tehKaiN/plipUltimate/(threads)

Thread 1 (2017-03-11):

Rev3 PCB

tehKaiN, 2017-03-11:
- [ ] proper power selector circuit
- [ ] better eth connector footprint - current is hard to source. Perhaps it'd be better to use non-LED variant & move leds to PCB
- [ ] CON5 should be place a bit lower
- [ ] Upper mounting hole of SD connector is too small
- [ ] Add power LED

LM2596 issues:
- [ ] L2 is wrongly wired, all LM2596 output should go through it
- [ ] C18 is wrongly wired, should be before power mux
