tehKaiN/plipUltimate/pcb/plipUltimate.kicad_pcb

## KiCad design pcb/plipUltimate.kicad_pcb (2016-05-31)

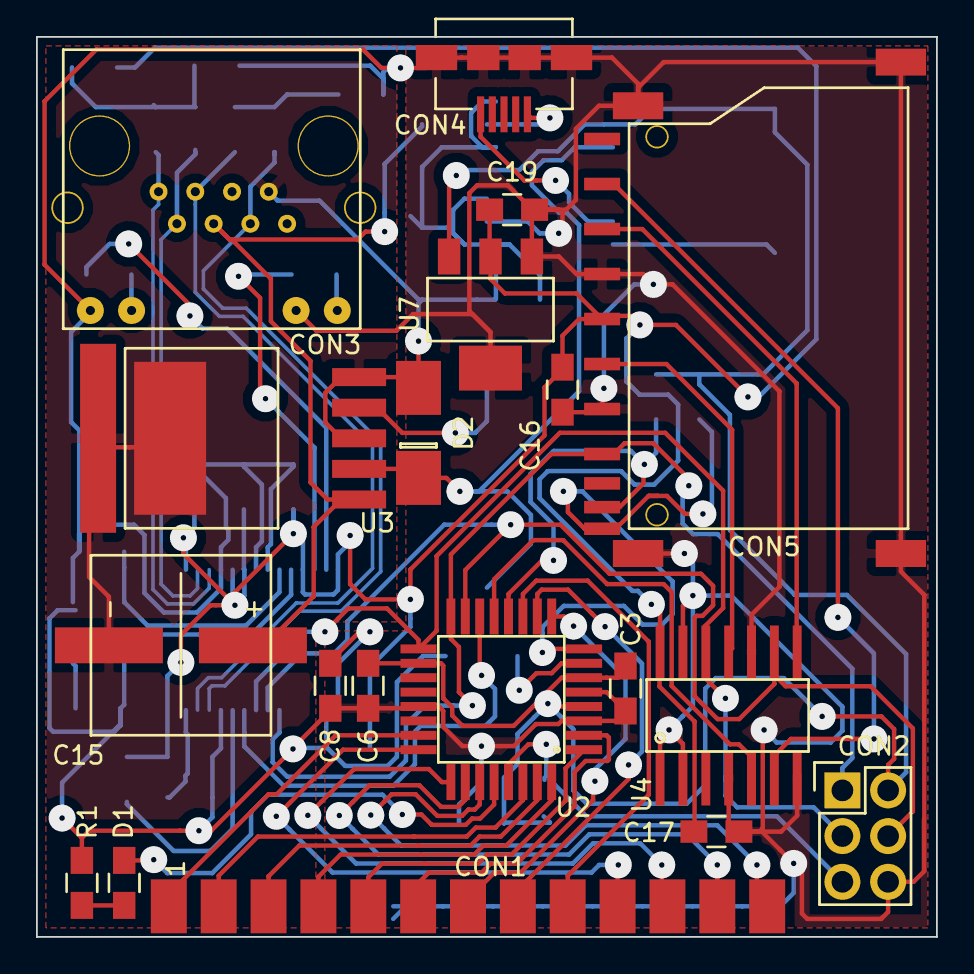
[picture p1: board plipUltimate.kicad_pcb from above]

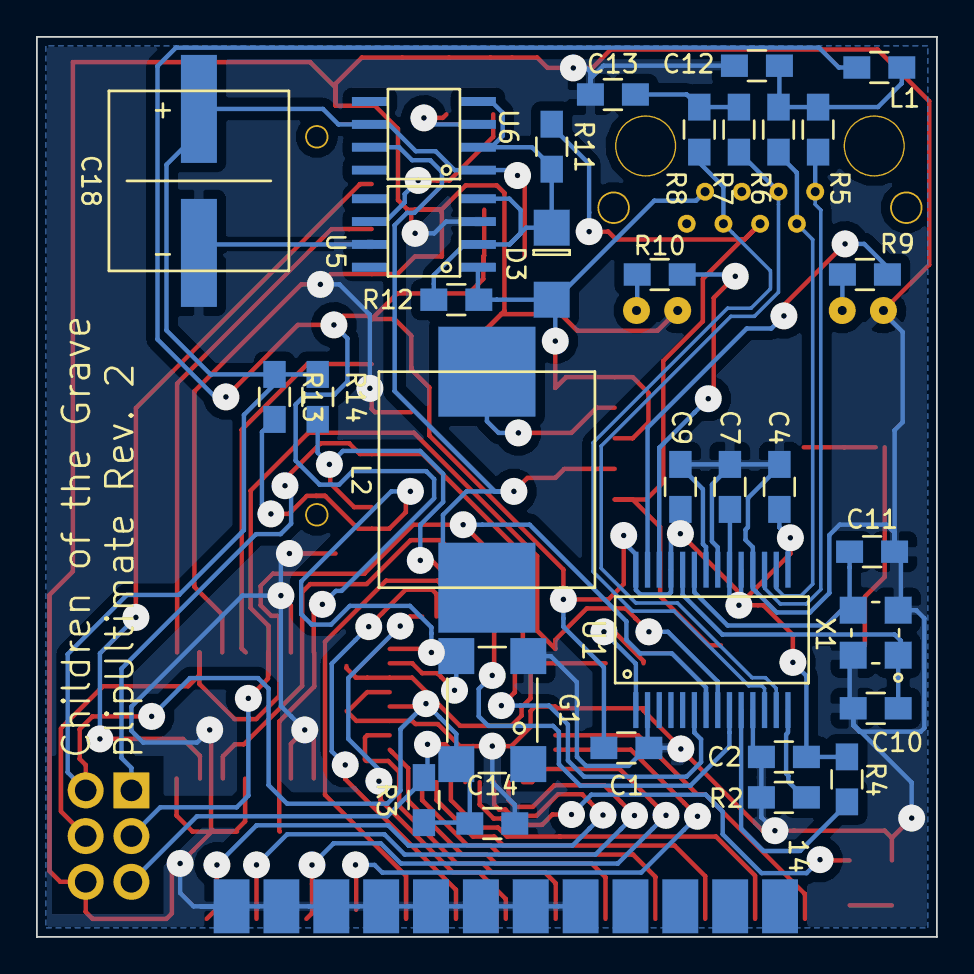
[picture p2: board plipUltimate.kicad_pcb from below]

Board: 2 copper layers, 50.0 x 50.0 mm, 51 parts (32 on the bottom side), 52 nets.

Parts:
C1, C2, C3, C4, C6, C7, C9, C14, C16: 100nF; 0805
C8: 10uF; 0805
C10, C11: 18pF; 0805
C12, C13, C17: 10nF; 0805
C15: 100uF 50V loESR; electrolyte_SMD
C18: 220uF 35V loESR; electrolyte_SMD
C19: 10uF 6,3V; 0805
CON1: IEEEE-1284A; d-sub25_edge
CON2: AVR-ISP-6; IDC_2x3
CON3: RJ45_C; RJ45-LEDS
CON4: USB_microB; USB-MicroB
CON5: SD_SPI; SD-SHORT
D1: YEL_LED; 0805
D2: SS34; SMA
D3: BZV55C10; SOD-80
G1: CFPS-72-20M; SMD_7050
L1: FB 100mA; 0805
L2: DE1207-100; DE-1207
R1: 820R; 0805
R2: 2k7 1%; 0805
R3, R4, R12: 10k; 0805
R5, R6, R7, R8: 49R9 1%; 0805
R9, R10: 270R; 0805
R11: 22k; 0805
R13, R14: 4k7; 0805
U1: ENC28J60; SSOP-28
U2: ATMEGA328P; TQFP-32
U3: LM2596_5.0; TO-263
U4: 74LVC125; SO-14
U5, U6: IRF7309; SO-8
U7: AMS1117_3V3; SOT-223
X1: 25MHz; XT-324

Connections:
3.3V_AVR_MOSI: CON5.2, U4.8
3.3V_AVR_SCK: CON5.5, U4.11
3.3V_SD_CS: CON5.1, U4.6
+3V3: C1.2, C2.2, C4.2, C7.2, C9.2, C16.1, C17.1, C19.1, CON5.4, L1.1, R4.1, U1.15, U1.19, U1.20, U1.25, U1.28, U4.14, U7.2
+5V: C3.1, C6.1, C14.1, C18.1, CON2.2, G1.4, R3.1, R13.1, R14.1, U2.4, U2.6, U2.18, U6.1, U6.6, U7.3
/AVR_CLK: G1.3, U2.7
/BUSY: CON1.11, U2.25
/D0: CON1.2, U2.30
/D1: CON1.3, U2.31
/D2: CON1.4, U2.32
/D3: CON1.5, U2.1
/D4: CON1.6, U2.2
/D5: CON1.7, U2.9
/D6: CON1.8, U2.10
/D7: CON1.9, U2.11
/LEDA: R9.2, U1.27
/LEDB: R10.2, U1.26
/OSC1: C11.2, U1.23, X1.3
/OSC2: C10.2, U1.24, X1.1
/POUT: CON1.12, U2.26
/RX+: CON3.3, R7.1, U1.13
/RX-: CON3.6, R8.1, U1.12
/SEL: CON1.13, U2.27
/TX+: CON3.1, R5.2, U1.17
/TX-: CON3.2, R6.2, U1.16
/~ACK: CON1.10, U2.24
/~STROBE: CON1.1, U2.23
AVR_MISO: CON2.1, CON5.7, U1.6, U2.16
AVR_MOSI: CON2.4, U1.7, U2.15, U4.9
AVR_RESET: CON2.5, R3.2, U2.29
AVR_SCK: CON2.3, U1.8, U2.17, U4.12
ETH_CS: U1.9, U2.14
GND: C1.1, C2.1, C3.2, C4.1, C6.2, C7.1, C8.1, C9.1, C10.1, C11.1, C12.1, C13.1, C14.2, C16.2, C17.2, C18.2, C19.2, CON1.18, CON1.19, CON1.20, CON1.21, CON1.22, CON1.23, CON1.24, CON1.25, CON2.6, CON3.9, CON3.11, CON4.6, CON5.3, CON5.6, CON5.12, CON5.13, G1.2, R1.2, R2.2, U1.2, U1.11, U1.18, U1.21, U1.22, U2.3, U2.5, U2.21, U4.1, U4.2, U4.4, U4.7, U4.10, U4.13, U5.3, U5.7, U7.1, X1.2
unnamed: C8.2, U1.1
unnamed: C12.2, L1.2, R5.1, R6.1
unnamed: C13.2, R7.2, R8.2
unnamed: CON3.10, R9.1
unnamed: CON3.12, R10.1
unnamed: CON4.1, U6.3
unnamed: CON4.5, U5.6
unnamed: D1.1, R1.1
unnamed: D1.2, U2.28
unnamed: D2.1, L2.2, U3.2, U6.7
unnamed: D3.1, R11.1, R12.2, U5.2, U5.4, U6.2, U6.4
unnamed: L2.1, U3.4
unnamed: R2.1, U1.14
unnamed: R4.2, U1.10
POE_0V: C15.2, CON3.7, D2.2, D3.2, R12.1, U3.3, U3.5, U5.1
POE_+24V: C15.1, CON3.4, R11.2, U3.1
SD_CS: U2.13, U4.5
SD_DETECT: CON5.10, R13.2, U2.8
SD_LOCK: CON5.11, R14.2, U2.12
