tehKaiN/plipUltimate/src/main/cmdkey_table.c

/*
 * This file is part of PlipUltimate.
 * License: GPLv2
 * Full license: https://github.com/tehKaiN/plipUltimate/blob/master/LICENSE
 * Authors list: https://github.com/tehKaiN/plipUltimate/blob/master/AUTHORS
 */

#include <main/cmdkey_table.h>

#include <main/stats.h>
#include <main/base/uartutil.h>

/*
COMMAND_KEY(cmd_dump_stats)
{
  stats_dump_all();
}

CMDKEY_HELP(cmd_enter_bridge_mode, "enter bridge mode");
CMDKEY_HELP(cmd_enter_bridge_test_mode, "enter bridge test mode");
CMDKEY_HELP(cmd_enter_pio_test_mode, "enter PIO test mode");
CMDKEY_HELP(cmd_enter_pb_test_mode, "enter PB test mode");
CMDKEY_HELP(cmd_dump_stats, "dump statistics");
CMDKEY_HELP(cmd_reset_stats, "reset statistics");
CMDKEY_HELP(cmd_toggle_verbose, "toggle verbose output");
CMDKEY_HELP(cmd_send_test_packet, "send a test packet (pbtest mode)");
CMDKEY_HELP(cmd_send_test_packet_silent, "send a test packet (silent) (pbtest mode)");
CMDKEY_HELP(cmd_toggle_auto_mode, "toggle auto send (pbtest mode)");

const cmdkey_table_t PROGMEM cmdkey_table[] = {
  CMDKEY_ENTRY('s', cmd_dump_stats),
  { 0,0 }
};
*/
