tehKaiN/plipUltimate/src/main/pio_util.c

/*
 * This file is part of PlipUltimate.
 * License: GPLv2
 * Full license: https://github.com/tehKaiN/plipUltimate/blob/master/LICENSE
 * Authors list: https://github.com/tehKaiN/plipUltimate/blob/master/AUTHORS
 */

#include <main/pio_util.h>

#include <main/base/timer.h>
#include <main/pio.h>
#include <main/base/uartutil.h>
#include <main/stats.h>
#include <main/pkt_buf.h>
#include <main/config.h>

#include <main/net/net.h>
#include <main/net/eth.h>
#include <main/net/arp.h>
#include <main/net/ip.h>
#include <main/net/udp.h>
#include <main/spi/enc28j60.h>

uint8_t pio_util_get_init_flags()
{
  uint8_t flags = PIO_INIT_BROAD_CAST;

  if(g_sConfig.flow_ctl) {
    flags |= PIO_INIT_FLOW_CONTROL;
  }
  if(g_sConfig.full_duplex) {
    flags |= PIO_INIT_FULL_DUPLEX;
  }

  return flags;
}

/**
 * Receives data from ENC28j60, calculates stats & does logging.
 * @param pDataSize Pointer to addr to be filled with read data size.
 */
uint8_t pio_util_recv_packet(uint16_t *pDataSize)
{
  // Fetch packet from ENC28j60, measure elapsed time
  timerReset();
  uint8_t ubRecvResult = enc28j60_recv(g_pDataBuffer, DATABUF_SIZE, pDataSize);
  uint16_t uwTimeDelta = timerGetState();
  uint16_t uwDataRate = timerCalculateKbps(*pDataSize, uwTimeDelta);

  if(ubRecvResult == PIO_OK) {
		// Update stats - write new data size & rate
    stats_update_ok(STATS_ID_PIO_RX, *pDataSize, uwDataRate);
  }
  else {
		// Update stats - increase error count
    stats_get(STATS_ID_PIO_RX)->err++;
  }

  return ubRecvResult;
}

uint8_t pio_util_send_packet(uint16_t size)
{
  timerReset();
  uint8_t result = enc28j60_send(g_pDataBuffer, size);
  // NOTE(KaiN#7): Is it really that short?
  uint16_t delta = timerGetState();

  uint16_t rate = timerCalculateKbps(size, delta);
  if(result == PIO_OK) {
    stats_update_ok(STATS_ID_PIO_TX, size, rate);
  }
  else {
    stats_get(STATS_ID_PIO_TX)->err++;
  }

  return result;
}
