tehKaiN/plipUltimate/(commit log)

2016-05-17 Added global pinout config, introduced SPI SD card support
2016-05-17 file reorganization, added spi support for card reader
2016-05-17 converted to stdint.h types, minor fixes
    [bridge.c, cmd.c, cmd.h, cmd_table.c]
2016-05-17 added PCB KiCad project
    [plipUltimate.kicad_pcb, plipUltimate.sch]
2016-05-18 Minor KiCad schematic fixes
    Tweaked resistor symbol, added SD decoupling, changed module layout on
    page
    [plipUltimate.sch]
2016-05-19 Added d-sub 25 edge connector footprint
2016-05-19 Added hand solder footprints, MOSFET gate powered by zener regulator
    [plipUltimate.sch]
2016-05-20 Decoupling for 7407, minor schematic tweaks
    most parts are associated with footprints, added more of them
    [plipUltimate.sch]
2016-05-21 All footprints done!
    [plipUltimate.sch]
2016-05-21 Laid out power circuit
    [plipUltimate.kicad_pcb, plipUltimate.sch]
2016-05-22 Changed eth crystal to 3-pin SMD, all parts are aligned on board now
    [plipUltimate.sch]
2016-05-22 further layout work - 25 connections to go
    [plipUltimate.kicad_pcb, plipUltimate.sch]
2016-05-24 everything routed!
    TODO: home-etching optimizations
    [plipUltimate.kicad_pcb]
2016-05-26 Revised schematic, reroute in progress
    [plipUltimate.kicad_pcb, plipUltimate.sch]
2016-05-30 Complete rev 2 sch and PCB
    [plipUltimate.kicad_pcb, plipUltimate.sch]
2016-05-30 minor pcb fixes
    TODO: 20MHz & SD footprints are broken
    [plipUltimate.kicad_pcb]
2016-05-31 further layout optimizations
    [plipUltimate.kicad_pcb]
2016-05-31 minor layout tweaks
    [plipUltimate.kicad_pcb]
2016-06-01 Rev 2.1, associated footprints with 3D models
    This release is not suitable for home etching
    [plipUltimate-B.Cu.gbl, plipUltimate-B.Mask.gbs, plipUltimate-B.SilkS.gbo, plipUltimate-Edge.Cuts.gm1, plipUltimate-F.Cu.gtl, plipUltimate-F.Mask.gts, plipUltimate-F.SilkS.gto, plipUltimate-NPTH-drl_map.gbr]
2016-06-02 UART comm removal
2016-06-02 beginning of UART message analysis
    first step in replacing UART comm with parallel comm
2016-12-20 kicad project minor changes
    [plipUltimate.sch]
2016-12-20 Some fixes for 20MHz. Further code documenting.
    [bridge.c, main.c, pb_proto.c]
2016-12-25 Refactored timer code.
    Should be now clock-independent, also revealed some problems regarding kbps calc
    [enc28j60.c, main.c, pb_proto.c, pio_util.c, timer.c, timer.h]
2016-12-26 Amiga command interface stub
    Although reset command should now work in bridge mode
    [bridge.c, cmd.c, cmd.h, main.c]
2016-12-26 Added status led support
2016-12-28 Added plipTool, made device resettable from it, proper wdt fns
    added no enc28j60 mode for debugging purposes
    [bridge.c, enc28j60.c, fuse.c, main.c, pb_proto.c, pinout.h]
2017-01-10 Added gitignore to KiCad part
2017-01-17 Fixed erroreous LED_PIN use
    [main.c, pinout.h, util.c]
2017-01-17 fixed cmd /ACK release
    [bridge.c]
2017-01-17 Prolonged /ACK pulse to 20ms, fixed plipTool CIA int handling
    plipTool now receives data from plipUltimate, albeit wrong.
    [ack.c, main.c, pb_proto.c]
2017-01-17 Added proper build version, typo fix in getconfig ip display
    [buildver.h, main.c]
2017-01-17 Remove not needed comment
    ACK prolonging was required for proper int detection, making it shorter won't make a difference in anything.
    [pb_proto.c]
2017-01-19 Added hex2puf util
    Works on windows, on Amiga it doesn't - buggy VBCC std lib?
    [main.c]
2017-01-19 Fixed hex2puf on m68k
    Crashes were stack-related. Changed big allocs to heap.
    [main.c]
2017-01-21 bootloader's PAR_DATA_PIN doesn't work, wtf
    [cmd.c, cmd.h, data.c, data.h, fuse.c, main.c, main.h, par.c]
2017-01-23 Refactored & reorganized code a bit - removed test modes & UART dump fns
2017-01-23 Removed UART verbose mode
2017-01-25 Added missing comment to bootloader code
    [main.c]
2017-01-25 Refactored SPI fn names
2017-01-25 ENC28J60 activity indicator - LED is dimmed if disabled
2017-02-04 unified passive component values
    [plipUltimate.sch]
2017-02-04 updated schematic meta table
    [plipUltimate.sch]
2017-02-05 Updated pcb meta table
2017-12-11 removed gerbers & binaries
    [plipUltimate-B.Cu.gbl, plipUltimate-B.Mask.gbs, plipUltimate-B.SilkS.gbo, plipUltimate-Edge.Cuts.gm1, plipUltimate-F.Cu.gtl, plipUltimate-F.Mask.gts, plipUltimate-F.SilkS.gto, plipUltimate-NPTH-drl_map.gbr]
